MX-LZX/Catch-Contact-the-Force/2.Software/PINN+MLP/data_utils/READMD.md

convert_excel_dataset_time.py：修改为时间序列npy数据
convert_excel_dataset.py：生成npy数据
dataform.py：每5行随机打乱数据
generate_sensor_coords.py：生成标志检测归一化
