MX-LZX/Catch-Contact-the-Force/1.Hardware/PCB/Pic/RP2040/Power.png

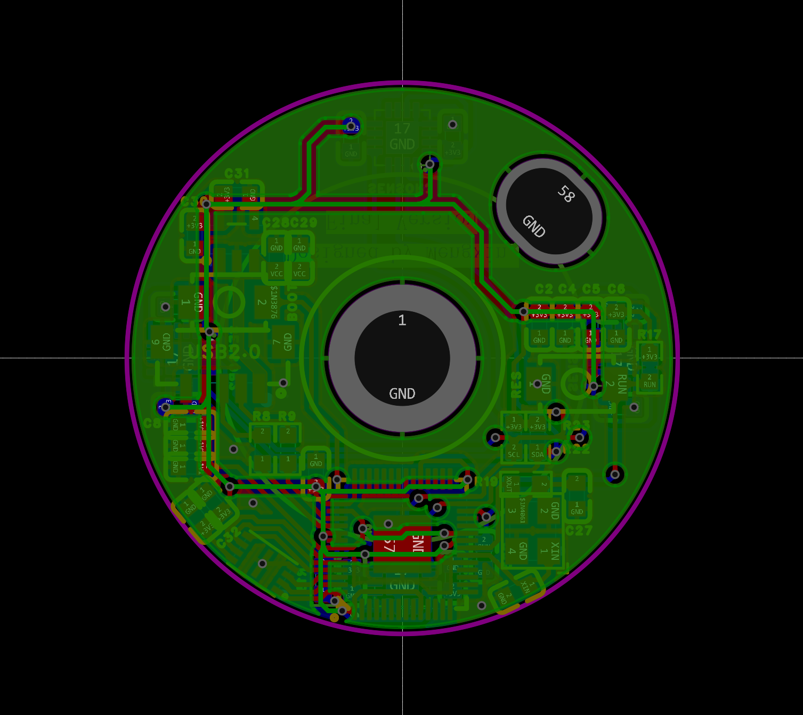
1.Hardware/PCB/Pic/RP2040/Power.png
