MX-LZX/Catch-Contact-the-Force/1.Hardware/PCB/Pic/RP2350A/Up.png

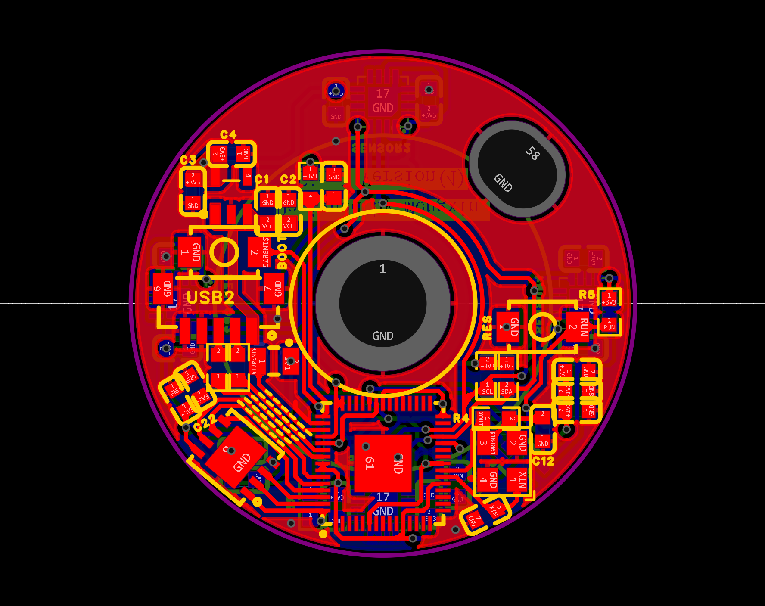
1.Hardware/PCB/Pic/RP2350A/Up.png
