MX-LZX/Catch-Contact-the-Force/1.Hardware/SW/Picture/微信图片_20250903180905_7_184.png

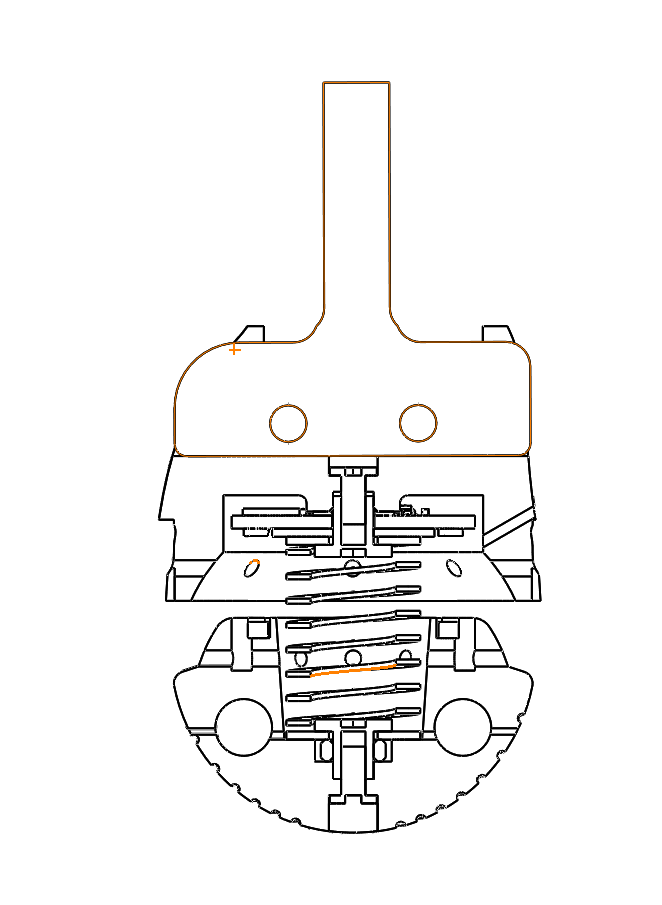
1.Hardware/SW/Picture/微信图片_20250903180905_7_184.png
