MX-LZX/Catch-Contact-the-Force/1.Hardware/SW/Picture/足端.png

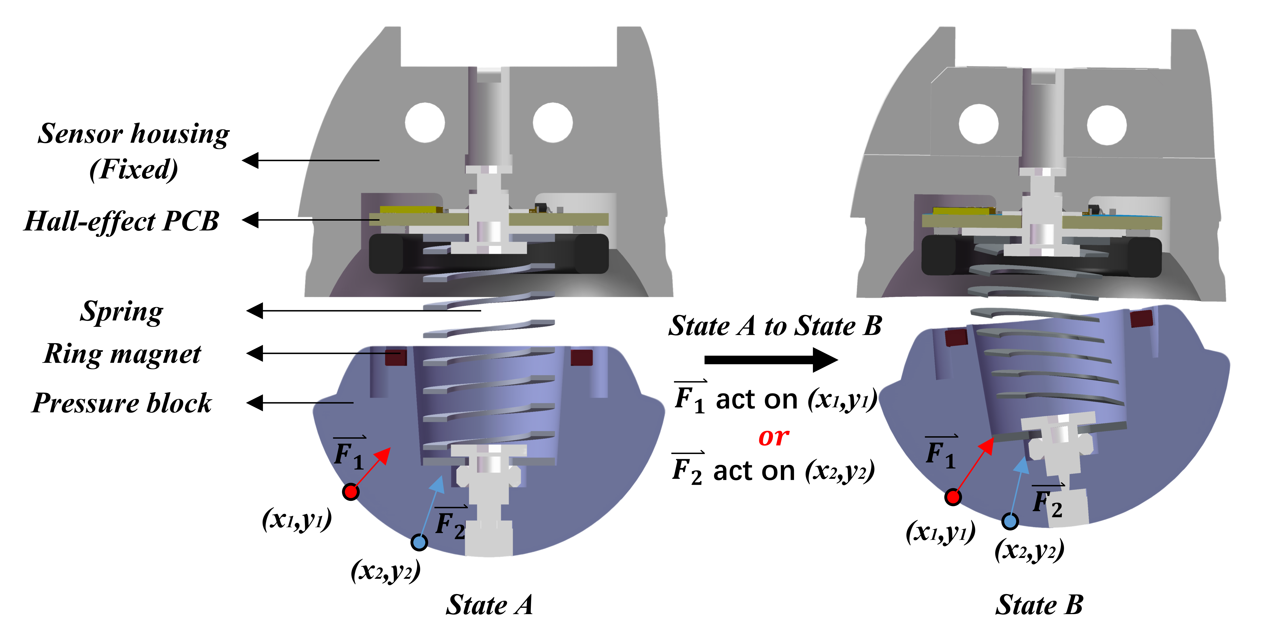
1.Hardware/SW/Picture/足端.png
