MX-LZX/Catch-Contact-the-Force/2.Software/PINN+MLP/checkpoints/loss_curve.png

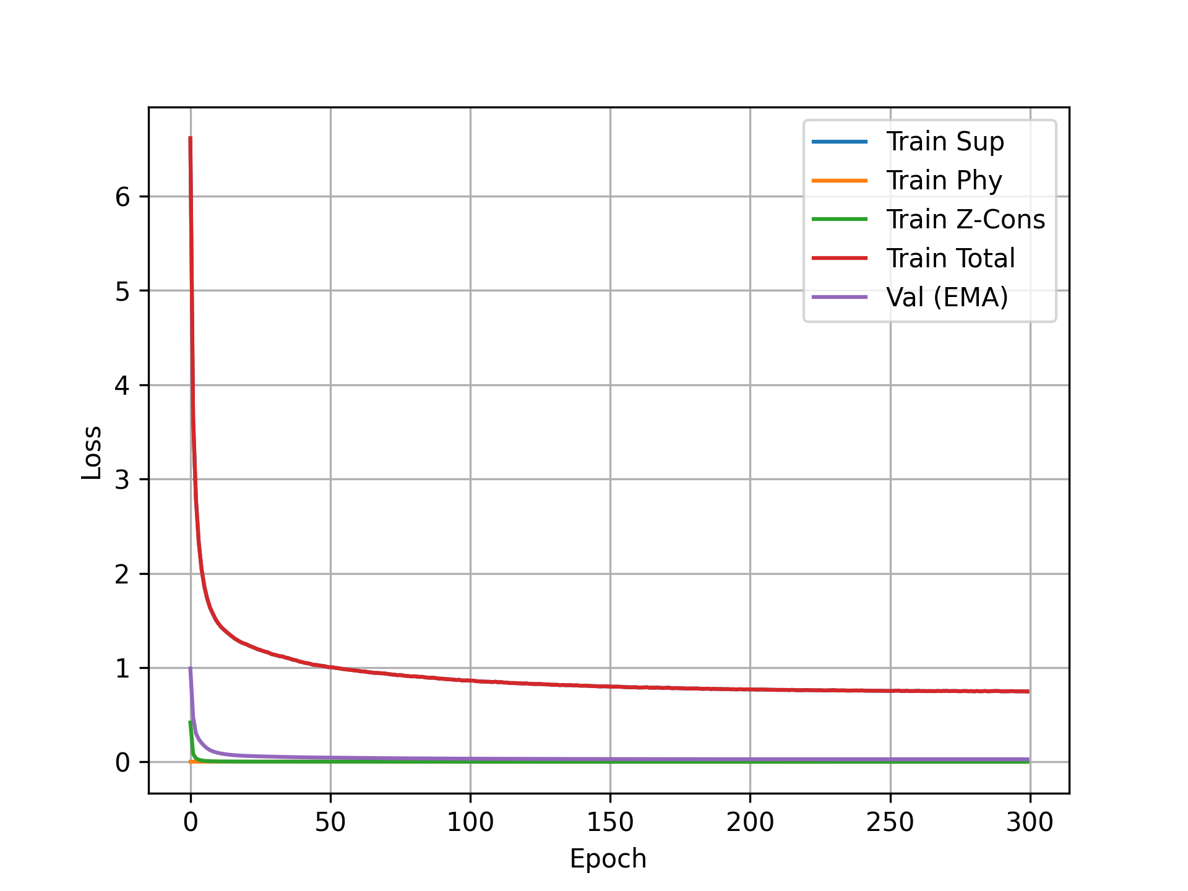
2.Software/PINN+MLP/checkpoints/loss_curve.png
