MX-LZX/Catch-Contact-the-Force/hardware/PCB/Pic/Gnd.png

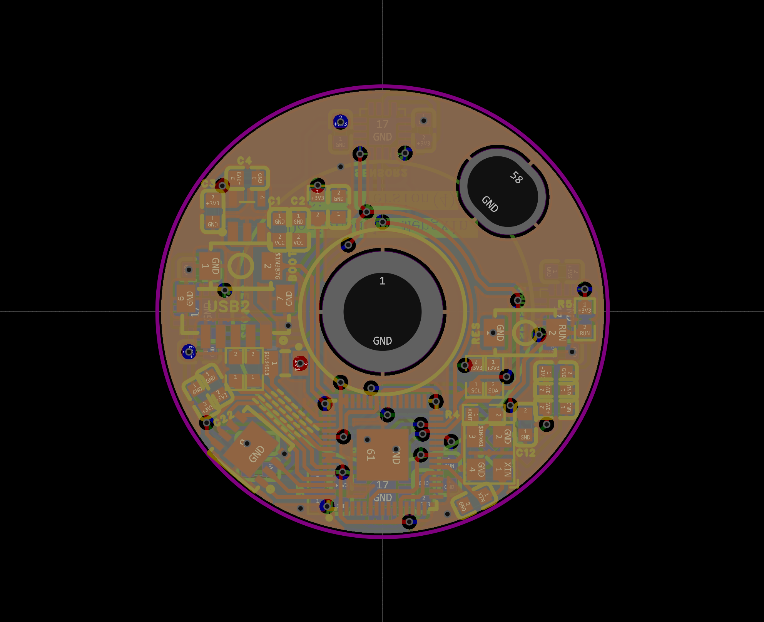
hardware/PCB/Pic/Gnd.png
