MX-LZX/Catch-Contact-the-Force/hardware/Spring/Spring.jpg

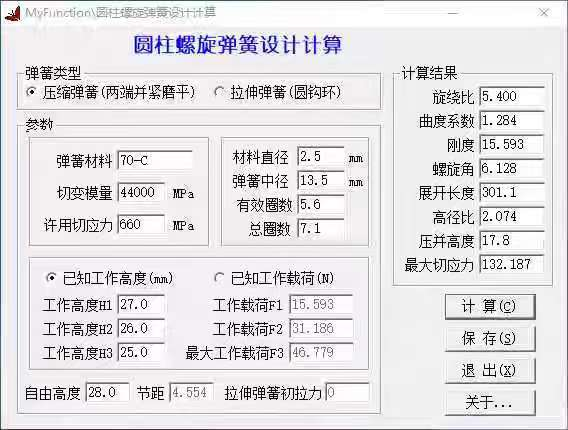
hardware/Spring/Spring.jpg
