MX-LZX/Catch-Contact-the-Force/hardware/SW/Picture/半剖面足端.png

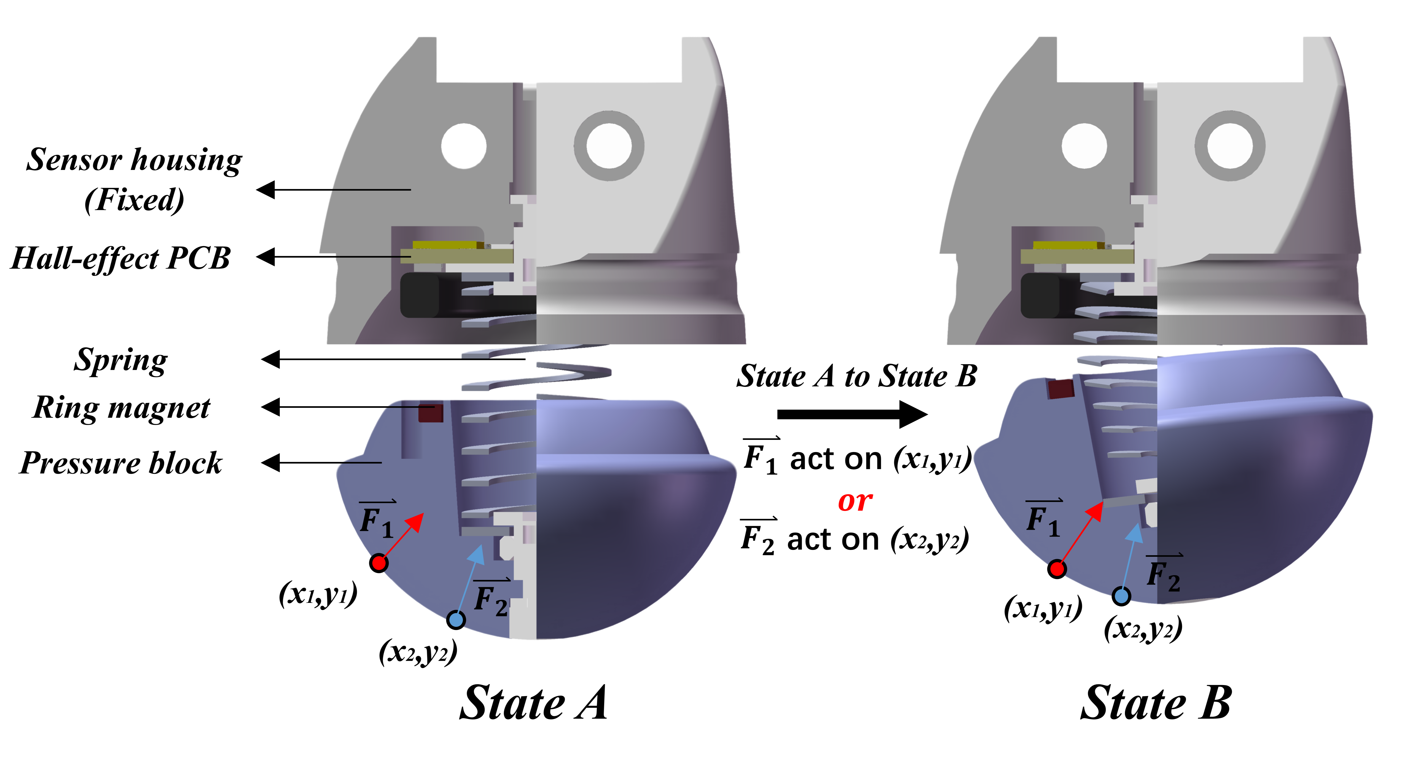
hardware/SW/Picture/半剖面足端.png
