MX-LZX/Catch-Contact-the-Force/1.Hardware/PCB/BOM/BOM_rp2040-mlx90393(4)_Sch.xlsx

No. | Quantity | Comment | Designator | Footprint | Value | Manufacturer Part | Manufacturer | Supplier Part | Supplier
1 | 2 | TS-1071AD-A1B3-D4 | BOOT,RES | SW-SMD_L4.0-W3.0-LS4.8 |  | TS-1071AD-A1B3-D4 | Yuandi(元迪) | C492878 | LCSC
2 | 19 | 100nF | C1,C2,C4,C5,C6,C9,C10,C25,C29,C31,C33,C34,C35,C36,C37,C38,C39,C40,C41 | C0603 | 100nF | CGA0603X7R104K500JT | HRE(芯声) | C6119867 | LCSC
3 | 1 | 1uF | C8 | C0603 | 1uF | CGA0603X5R105K500JT | HRE(芯声) | C6119852 | LCSC
4 | 2 | 15pF | C26,C27 | C0603 | 15pF | CC0603JRNPO9BN150 | YAGEO(国巨) | C107037 | LCSC
5 | 3 | 2.2uF | C28,C30,C32 | C0603 | 2.2uF | CL10A225KB8NNNC | SAMSUNG(三星) | C913904 | LCSC
6 | 1 | ME6211C33M5G-N | LDO1 | SOT-23-5_L3.0-W1.7-P0.95-LS2.8-BL |  | ME6211C33M5G-N | MICRONE(南京微盟) | C82942 | LCSC
7 | 2 | 27Ω | R8,R9 | R0603 | 27Ω | FRC0603F27R0TS | FOJAN(富捷) | C2907021 | LCSC
8 | 1 | 10kΩ | R17 | R0603 | 10kΩ | RC0603FR-0710KL | YAGEO(国巨) |  | LCSC
9 | 1 | 1kΩ | R18 | R0603 | 1kΩ | RC0603FR-0710KL | YAGEO(国巨) |  | LCSC
10 | 1 | 1kΩ | R19 | R0603 | 1kΩ | 0603WAF1001T5E | UNI-ROYAL(厚声) | C21190 | LCSC
11 | 2 | 10kΩ | R22,R23 | R0603 | 10kΩ | 0603WAF4701T5E | UNI-ROYAL(厚声) |  | LCSC
12 | 4 | MLX90393SLW-ABA-011-RE | SENSOR1,SENSOR2,SENSOR3,SENSOR4 | VQFN-16_L3.0-W3.0-P0.50-BL-EP1.7 |  | MLX90393SLW-ABA-011-RE | Melexis(比利时迈来芯) | C2649492 | LCSC
13 | 1 | RP2040 | U1 | LQFN-56_L7.0-W7.0-P0.4-EP |  | RP2040 | Raspberry Pi(树莓派) | C2040 | LCSC
14 | 1 | W25Q16JVUXIQ | U4 | USON-8_L3.0-W2.0-P0.50-BL-EP |  | W25Q16JVUXIQ | WINBOND(华邦) | C2843335 | LCSC
15 | 1 | WAFER-SH1.0-5PLB | USB2.0 | CONN-SMD-5P-P1.00_BM05B-SRSS-TB-LF-SN |  | WAFER-SH1.0-5PLB | XUNPU(讯普) | C3029335 | LCSC
16 | 1 | 12MHz | X1 | OSC-SMD_4P-L3.2-W2.5-BL | 12MHz | X322512MSB4SI | YXC(扬兴晶振) | C9002 | LCSC
