MX-LZX/Catch-Contact-the-Force/1.Hardware/PCB/BOM/BOM_rp2350-mlx90393(4)_Sch.xlsx

No. | Quantity | Comment | Designator | Footprint | Value | Manufacturer Part | Manufacturer | Supplier Part | Supplier
1 | 2 | TS-1071AD-A1B3-D4 | BOOT,RES | SW-SMD_L4.0-W3.0-LS4.8 |  | TS-1071AD-A1B3-D4 | Yuandi(元迪) | C492878 | LCSC
2 | 3 | 2.2uF | C1,C3,C22 | C0603 | 2.2uF | CL10A225KB8NNNC | SAMSUNG(三星) | C913904 | LCSC
3 | 14 | 100nF | C2,C4,C8,C9,C11,C13,C14,C15,C16,C17,C18,C20,C21,C23 | C0603 | 100nF | CGA0603X7R104K500JT | HRE(芯声) | C6119867 | LCSC
4 | 4 | 4.7uF | C5,C6,C7,C19 | C0603 | 4.7uF | 0603F475M160NT | FH(风华) | C94039 | LCSC
5 | 2 | 15pF | C10,C12 | C0603 | 15pF | CC0603JRNPO9BN150 | YAGEO(国巨) | C107037 | LCSC
6 | 1 | AOTA-B201610S3R3-101-T | L1 | IND-SMD_L2.0-W1.6_AOTA-B201610S3R3-101-T |  | AOTA-B201610S3R3-101-T | ABRACON | C42411119 | LCSC
7 | 1 | ME6211C33M5G-N | LDO1 | SOT-23-5_L3.0-W1.7-P0.95-LS2.8-BL |  | ME6211C33M5G-N | MICRONE(南京微盟) | C82942 | LCSC
8 | 2 | 27Ω | R1,R2 | R0603 | 27Ω | FRC0603F27R0TS | FOJAN(富捷) | C2907021 | LCSC
9 | 1 | 33Ω | R3 | R0603 | 33Ω | FRC0603F33R0TS | FOJAN(富捷) | C2909394 | LCSC
10 | 1 | 1kΩ | R4 | R0603 | 1kΩ | 0603WAF1001T5E | UNI-ROYAL(厚声) | C21190 | LCSC
11 | 1 | 10kΩ | R5 | R0603 | 10kΩ | RC0603FR-0710KL | YAGEO(国巨) |  | LCSC
12 | 1 | 1kΩ | R6 | R0603 | 1kΩ | RC0603FR-0710KL | YAGEO(国巨) |  | LCSC
13 | 2 | 10kΩ | R7,R8 | R0603 | 10kΩ | 0603WAF4701T5E | UNI-ROYAL(厚声) |  | LCSC
14 | 4 | MLX90393SLW-ABA-011-RE | SENSOR1,SENSOR2,SENSOR3,SENSOR4 | VQFN-16_L3.0-W3.0-P0.50-BL-EP1.7 |  | MLX90393SLW-ABA-011-RE | Melexis(比利时迈来芯) | C2649492 | LCSC
15 | 1 | RP2350A | U1 | QFN-60_L7.0-W7.0-P0.40-TL-EP3.4 |  | RP2350A | Raspberry Pi(树莓派) | C42411118 | LCSC
16 | 1 | W25Q64JVXGIQ | U2 | XSON-8_L4.0-W4.0-P0.80-TL-EP |  | W25Q64JVXGIQ | WINBOND(华邦) | C2940195 | LCSC
17 | 1 | MCP9700AT-E/LT | U3 | SC-70-5_L2.1-W1.3-P0.65-LS2.1-TL |  | MCP9700AT-E/LT | MICROCHIP(美国微芯) | C97546 | LCSC
18 | 1 | WAFER-SH1.0-5PLB | USB2 | CONN-SMD-5P-P1.00_BM05B-SRSS-TB-LF-SN |  | WAFER-SH1.0-5PLB | XUNPU(讯普) | C3029335 | LCSC
19 | 1 | 12MHz | X1 | OSC-SMD_4P-L3.2-W2.5-BL | 12MHz | X322512MSB4SI | YXC(扬兴晶振) | C9002 | LCSC
