MX-LZX/Catch-Contact-the-Force/1.Hardware/SW/总装.STEP

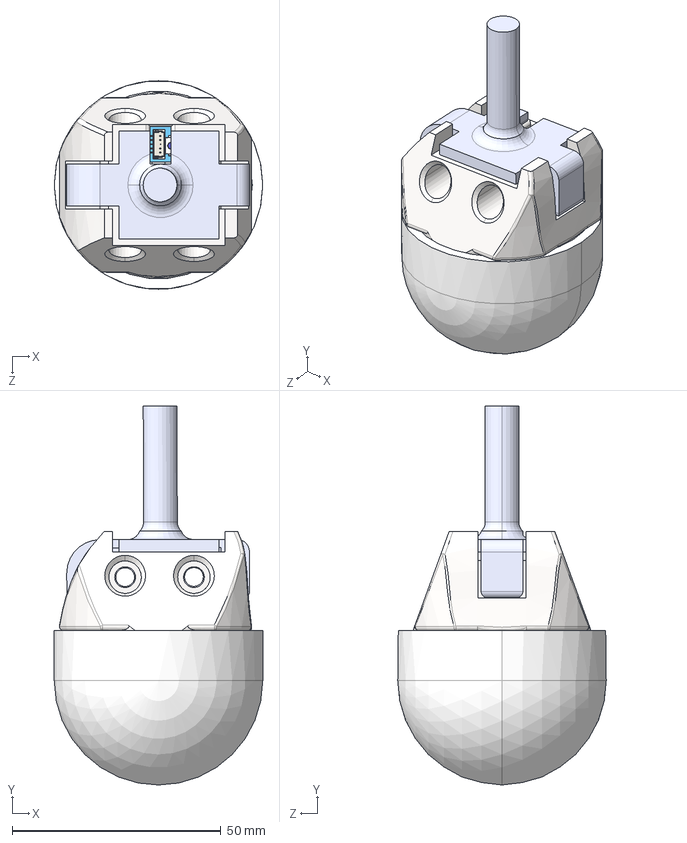
[picture p16: CAD file, 2025-10-13]
1.Hardware/SW/总装.STEP
50.0 x 90.9 x 50.0 mm
足端主体
潰聆輸
粟銅
海绵缓冲物
寡蝶菜5-10-0.5
寡蝶菜5-20-1
半球柔性保护套
环形磁铁
ﾄﾚﾍ簷ﾀﾂﾝﾋｿ x 2
m3蹟佪 x 2
沓喃輸
COMPOUND.step x 2
SOLID.step
SOLID-0.step
COMPOUND-1.step x 7
SOLID-2.step
COMPOUND-3.step
SOLID-4.step x 25
SOLID-5.step x 4
COMPOUND-6.step
COMPOUND-7.step
嘐隅璃
m5情蹟譫
崨湍 x 8
