MX-LZX/Catch-Contact-the-Force/hardware/SW/检测块.STEP

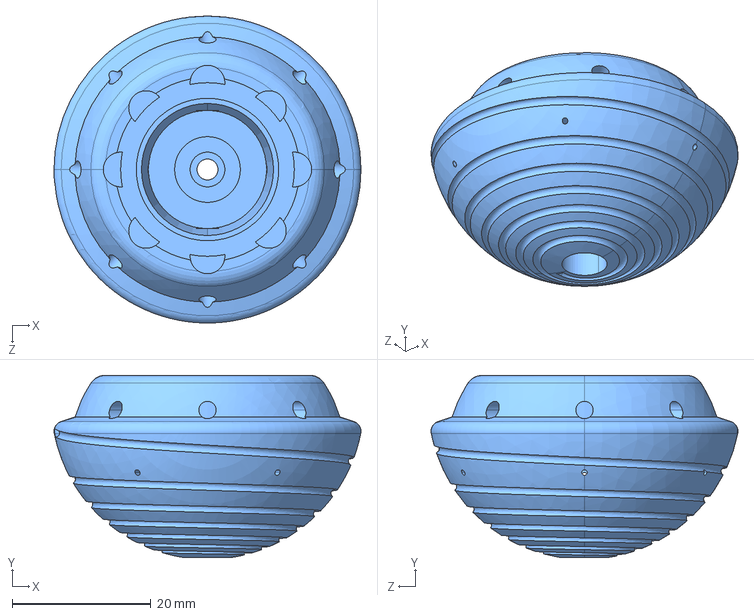
[picture p17: CAD file, 2025-09-25]
hardware/SW/检测块.STEP
44.2 x 26.3 x 44.2 mm
