MX-LZX/Catch-Contact-the-Force/1.Hardware/SW/填充块.STEP

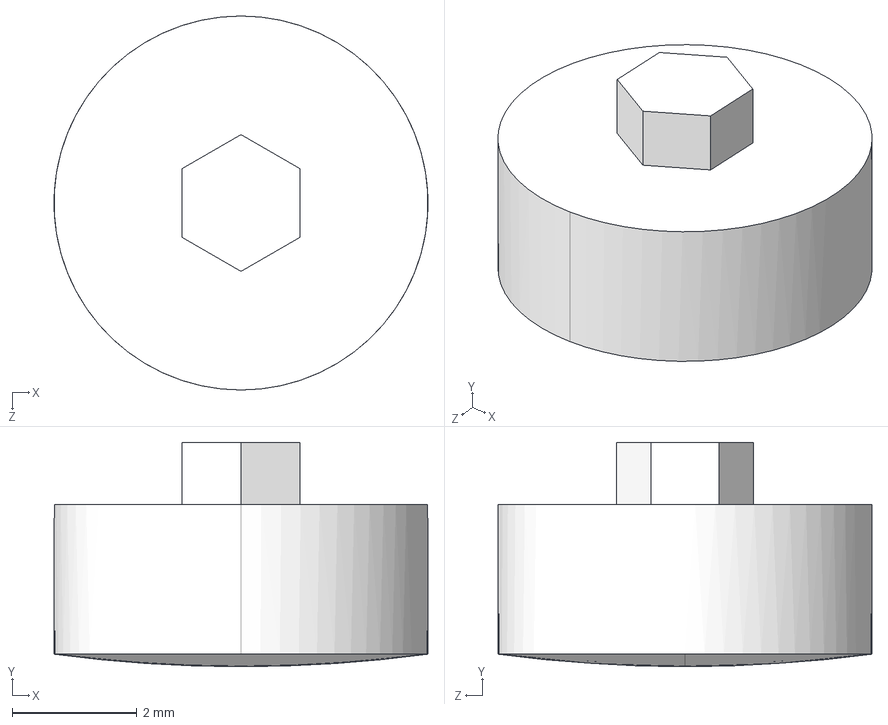
[picture p18: CAD file, 2025-09-25]
1.Hardware/SW/填充块.STEP
6.00 x 3.60 x 6.00 mm
