MX-LZX/Catch-Contact-the-Force/1.Hardware/SW/固定件.STEP

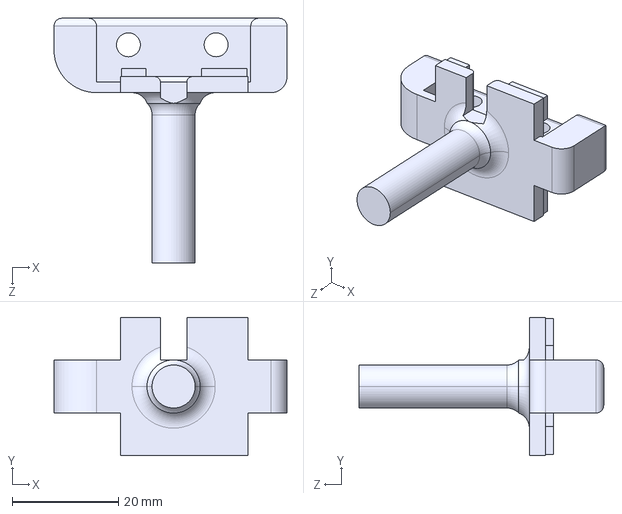
[picture p19: CAD file, 2025-09-25]
1.Hardware/SW/固定件.STEP
43.8 x 26.0 x 46.0 mm
