MX-LZX/Catch-Contact-the-Force/1.Hardware/SW/足端主体.STEP

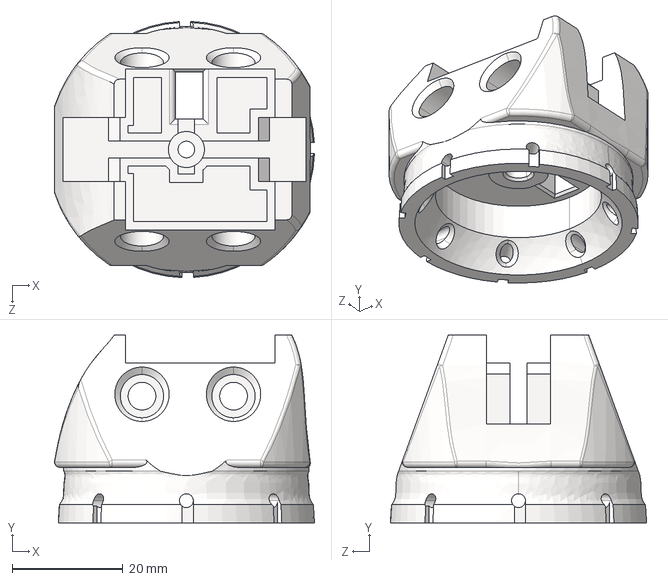
[picture p20: CAD file, 2025-09-25]
1.Hardware/SW/足端主体.STEP
46.9 x 33.8 x 46.2 mm
