MX-LZX/Catch-Contact-the-Force/(list of files, cad)

Other CAD files:
1.Hardware/DWG/背铁.DWG
1.Hardware/SW/总装.SLDASM
