MX-LZX/Catch-Contact-the-Force/2.Software/PINN+MLP/pred_results_Fz.png

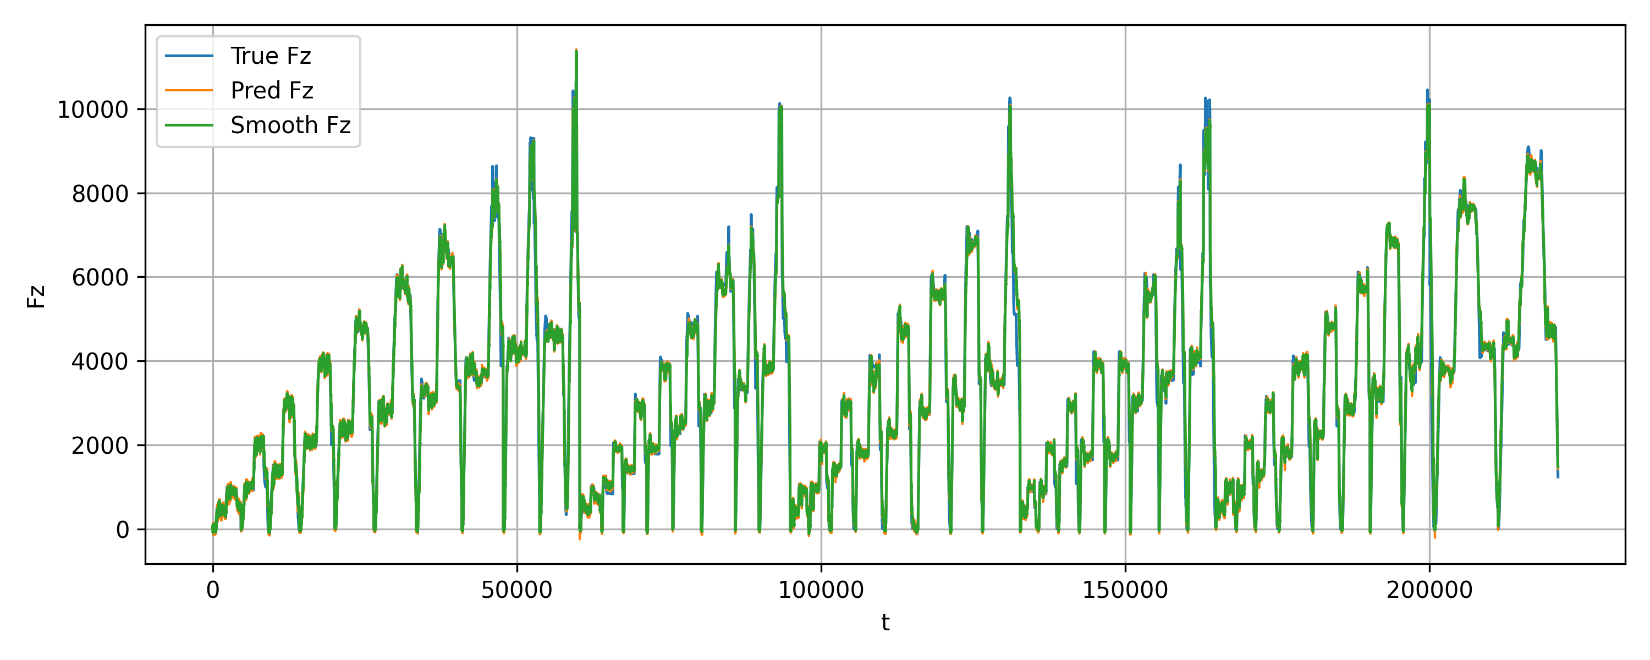
2.Software/PINN+MLP/pred_results_Fz.png
