MX-LZX/Catch-Contact-the-Force/1.Hardware/PCB/RP2040a-MLX90393(4)-SCH.pdf

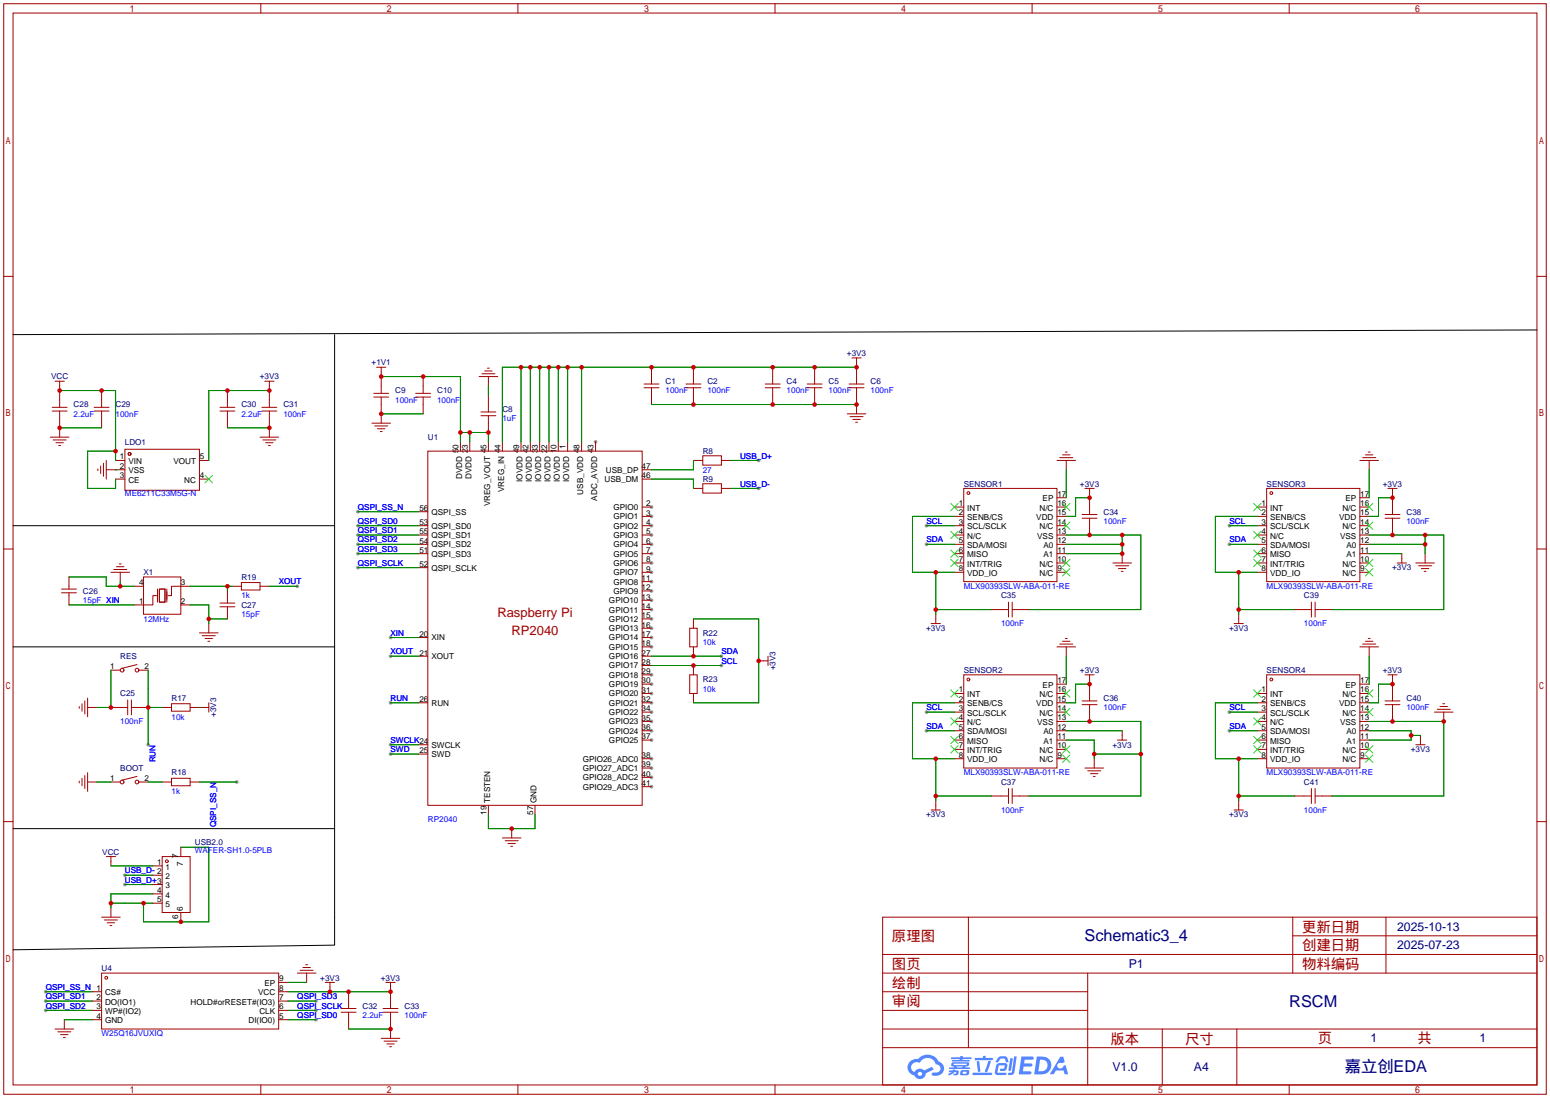
[picture p22: page 1]
