MX-LZX/Catch-Contact-the-Force/hardware/PCB/RP2350a-MLX90393(4)-SCH.pdf

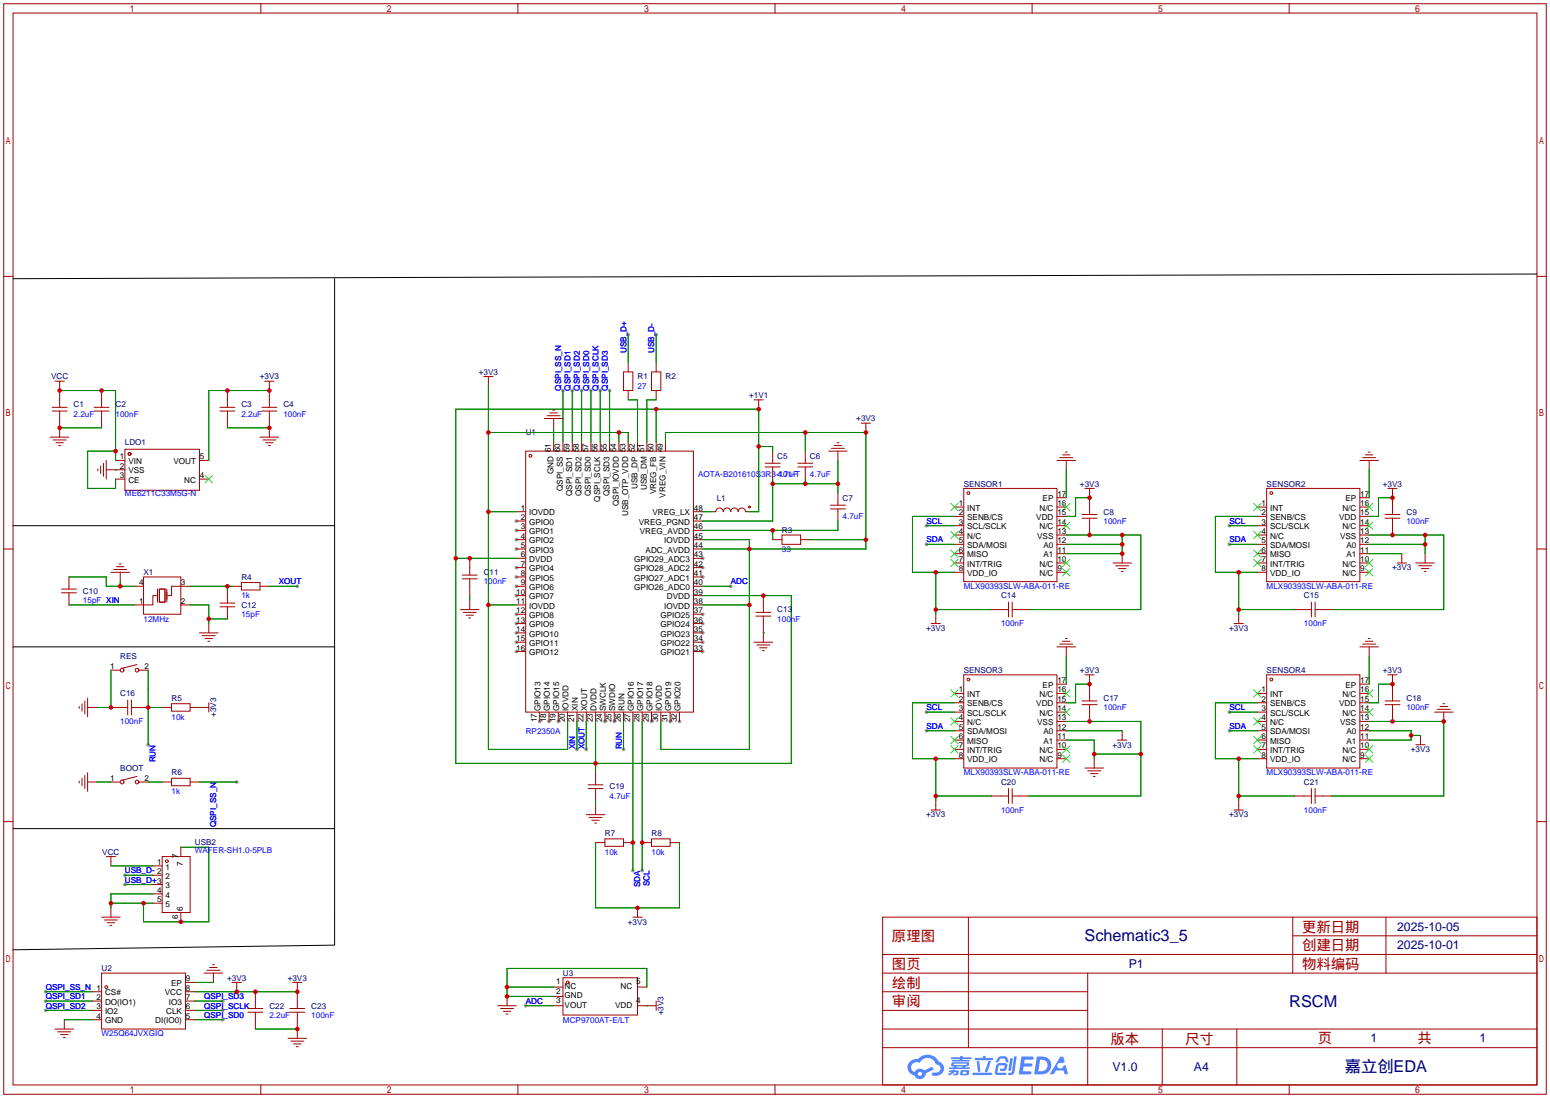
[picture p23: page 1]

GPIO21 33 GPIO22 34 GPIO23 35 GPIO24 36 GPIO25 37 IOVDD 38 DVDD 39 GPIO26_ADC0 40 GPIO27_ADC1 41 GPIO28_ADC2 42 GPIO29_ADC3 43 ADC_AVDD 44 IOVDD 45 VREG_AVDD 46 VREG_PGND 47 VREG_LX 48 VREG_VIN ⁴⁹ VREG_FB ⁵⁰ USB_DM ⁵¹ USB_DP ⁵² USB_OTP_VDD ⁵³ QSPI_IOVDD ⁵⁴ QSPI_SD³ ⁵⁵ QSPI_SCLK ⁵⁶ QSPI_SD⁰ ⁵⁷ QSPI_SD² ⁵⁸ QSPI_SD¹ ⁵⁹ QSPI_SS ⁶⁰
