MX-LZX/Catch-Contact-the-Force/(list of files, drawings)

Other design files:
1.Hardware/PCB/RP2040-MLX90393.epro
1.Hardware/PCB/RP2350-MLX90393(4).epro
hardware/PCB/RP2350-MLX90393(4).epro
